Didi0dum/GPR/synth-vco/synth-vco.csv

Reference | Qty | Value | DNP | Exclude from BOM | Exclude from Board | Exclude from Simulation | Exclude from Position Files | Footprint | Datasheet
AR1 | 1 | ADL5611ARKZ-R7 |  |  |  |  | ${EXCLUDE_FROM_POS_FILES} | GPR_Radar_Footprints:AMP_ADL5611ARKZ-R7 | https://www.analog.com/media/en/technical-documentation/data-sheets/adl5611.pdf
AT1 | 1 | PAT1220-C-3DB |  |  |  |  | ${EXCLUDE_FROM_POS_FILES} | GPR_Radar_Footprints:ATTN_PAT1220-C-10DB-T5 | https://www.mouser.com/catalog/specsheets/Susumu_01192017_PAT.pdf
C1,C11 | 2 | 1n |  |  |  |  | ${EXCLUDE_FROM_POS_FILES} | Capacitor_SMD:C_0603_1608Metric_Pad1.08x0.95mm_HandSolder
C2 | 1 | 1000p |  |  |  |  | ${EXCLUDE_FROM_POS_FILES} | Capacitor_SMD:C_0603_1608Metric_Pad1.08x0.95mm_HandSolder
C3,C10,C56,C57,C59,C61,C63 | 7 | 100n |  |  |  |  | ${EXCLUDE_FROM_POS_FILES} | Capacitor_SMD:C_0603_1608Metric_Pad1.08x0.95mm_HandSolder
C4,C5,C12,C13,C14,C20,C22,C66,C68,C72 | 10 | 100pF |  |  |  |  | ${EXCLUDE_FROM_POS_FILES} | Capacitor_SMD:C_0603_1608Metric_Pad1.08x0.95mm_HandSolder
C6 | 1 | 160nF |  |  |  |  | ${EXCLUDE_FROM_POS_FILES} | Capacitor_SMD:C_1206_3216Metric_Pad1.33x1.80mm_HandSolder
C7 | 1 | 5.6uF |  |  |  |  | ${EXCLUDE_FROM_POS_FILES} | Capacitor_SMD:C_1206_3216Metric_Pad1.33x1.80mm_HandSolder
C8,C50,C52,C53,C54 | 5 | 10n |  |  |  |  | ${EXCLUDE_FROM_POS_FILES} | Capacitor_SMD:C_0603_1608Metric_Pad1.08x0.95mm_HandSolder
C9 | 1 | 33nF |  |  |  |  | ${EXCLUDE_FROM_POS_FILES} | Capacitor_SMD:C_1206_3216Metric_Pad1.33x1.80mm_HandSolder
C15 | 1 | 68pF |  |  |  |  | ${EXCLUDE_FROM_POS_FILES} | Capacitor_SMD:C_0603_1608Metric_Pad1.08x0.95mm_HandSolder
C16 | 1 | 1.2nF |  |  |  |  | ${EXCLUDE_FROM_POS_FILES} | Capacitor_SMD:C_0603_1608Metric_Pad1.08x0.95mm_HandSolder
C17,C69 | 2 | 1uF |  |  |  |  | ${EXCLUDE_FROM_POS_FILES} | Capacitor_SMD:C_0603_1608Metric_Pad1.08x0.95mm_HandSolder
C18 | 1 | 100nF |  |  |  |  | ${EXCLUDE_FROM_POS_FILES} | Capacitor_SMD:C_0603_1608Metric_Pad1.08x0.95mm_HandSolder
C23,C31,C34,C36,C39,C42 | 6 | 4.7u |  |  |  |  | ${EXCLUDE_FROM_POS_FILES} | Capacitor_SMD:C_0805_2012Metric_Pad1.18x1.45mm_HandSolder
C24,C29,C30,C32,C33,C35,C38,C41,C44,C70 | 10 | 10u |  |  |  |  | ${EXCLUDE_FROM_POS_FILES} | Capacitor_SMD:C_0805_2012Metric_Pad1.18x1.45mm_HandSolder
C25,C27,C51,C55,C65 | 5 | 10u |  |  |  |  | ${EXCLUDE_FROM_POS_FILES} | Capacitor_SMD:C_1206_3216Metric_Pad1.33x1.80mm_HandSolder
C26,C28 | 2 | 22u |  |  |  |  | ${EXCLUDE_FROM_POS_FILES} | Capacitor_SMD:C_1206_3216Metric_Pad1.33x1.80mm_HandSolder
C37,C40,C43 | 3 | 0.47u |  |  |  |  | ${EXCLUDE_FROM_POS_FILES} | Capacitor_SMD:C_0603_1608Metric_Pad1.08x0.95mm_HandSolder
C45 | 1 | 470n |  |  |  |  | ${EXCLUDE_FROM_POS_FILES} | Capacitor_SMD:C_0603_1608Metric_Pad1.08x0.95mm_HandSolder
C46 | 1 | 0.1u |  |  |  |  | ${EXCLUDE_FROM_POS_FILES} | Capacitor_SMD:C_0603_1608Metric_Pad1.08x0.95mm_HandSolder
C47 | 1 | 2.2n |  |  |  |  | ${EXCLUDE_FROM_POS_FILES} | Capacitor_SMD:C_0603_1608Metric_Pad1.08x0.95mm_HandSolder
C48 | 1 | 47p |  |  |  |  | ${EXCLUDE_FROM_POS_FILES} | Capacitor_SMD:C_0603_1608Metric_Pad1.08x0.95mm_HandSolder
C49 | 1 | 4.7u |  |  |  |  | ${EXCLUDE_FROM_POS_FILES} | Capacitor_SMD:C_1206_3216Metric_Pad1.33x1.80mm_HandSolder
C58,C60,C62,C64 | 4 | 10p |  |  |  |  | ${EXCLUDE_FROM_POS_FILES} | Capacitor_SMD:C_0603_1608Metric_Pad1.08x0.95mm_HandSolder
C67 | 1 | 9pF |  |  |  |  | ${EXCLUDE_FROM_POS_FILES} | Capacitor_SMD:C_0603_1608Metric_Pad1.08x0.95mm_HandSolder
C71 | 1 | 1.8pF |  |  |  |  | ${EXCLUDE_FROM_POS_FILES} | Capacitor_SMD:C_0603_1608Metric_Pad1.08x0.95mm_HandSolder
C73,C74 | 2 | 2.2u |  |  |  |  | ${EXCLUDE_FROM_POS_FILES} | Capacitor_SMD:C_0805_2012Metric_Pad1.18x1.45mm_HandSolder
D1 | 1 | MSS1P4-M3_89A |  |  |  |  | ${EXCLUDE_FROM_POS_FILES} | GPR_Radar_Footprints:DIODE_MSS1P4-M3_89A
D3 | 1 | WE-TVSP_DO |  |  |  |  | ${EXCLUDE_FROM_POS_FILES} | GPR_Radar_Footprints:WE-TVSP_DO-214AC_UNIDIRECTIONAL | https://www.we-online.com/components/products/datasheet/824500141.pdf
F1 | 1 | MF-MSMF200/16X |  |  |  |  | ${EXCLUDE_FROM_POS_FILES} | GPR_Radar_Footprints:FUSER_MF-MSMF200 | https://www.mouser.bg/datasheet/3/40/1/mf_msmf.pdf
FL1,FL2 | 2 | BLM18EG331TZ1D |  |  |  |  | ${EXCLUDE_FROM_POS_FILES} | GPR_Radar_Footprints:BEADC1608X65N
FL3,FL4 | 2 | LFCN-900+ |  |  |  |  | ${EXCLUDE_FROM_POS_FILES} | Filter:Filter_Mini-Circuits_FV1206 | https://eu.mouser.com/datasheet/3/3705/1/LFCN_900.pdf
J1,J4 | 2 | Conn_Coaxial |  |  |  |  | ${EXCLUDE_FROM_POS_FILES} | Connector_Coaxial:SMA_Samtec_SMA-J-P-H-ST-EM1_EdgeMount
J2 | 1 | Screw_Terminal_01x02 |  |  |  |  | ${EXCLUDE_FROM_POS_FILES} | TerminalBlock_CUI:TerminalBlock_CUI_TB007-508-02_1x02_P5.08mm_Horizontal
J3 | 1 | 61202021621 |  |  |  |  | ${EXCLUDE_FROM_POS_FILES} | GPR_Radar_Footprints:J_Wurth_WR-BHD_61202021621 | https://www.we-online.com/en/components/products/datasheet/61202021621?ki
L1 | 1 | 43nH |  |  |  |  | ${EXCLUDE_FROM_POS_FILES} | Inductor_SMD:L_0603_1608Metric_Pad1.05x0.95mm_HandSolder
L2 | 1 | 47.0 uH |  |  |  |  | ${EXCLUDE_FROM_POS_FILES} | GPR_Radar_Footprints:L_Wurth_WE-LQS-4018 | https://www.we-online.com/catalog/datasheet/74404042470.pdf?ki
L3 | 1 | 82uH |  |  |  |  | ${EXCLUDE_FROM_POS_FILES} | Inductor_SMD:L_0805_2012Metric_Pad1.05x1.20mm_HandSolder
L5 | 1 | 82nH |  |  |  |  | ${EXCLUDE_FROM_POS_FILES} | Inductor_SMD:L_0603_1608Metric_Pad1.05x0.95mm_HandSolder
L6 | 1 | 3.9nH |  |  |  |  | ${EXCLUDE_FROM_POS_FILES} | Inductor_SMD:L_0603_1608Metric_Pad1.05x0.95mm_HandSolder
R1 | 1 | 5.1K |  |  |  |  | ${EXCLUDE_FROM_POS_FILES} | Resistor_SMD:R_0603_1608Metric_Pad0.98x0.95mm_HandSolder
R2,R23 | 2 | 2K |  |  |  |  | ${EXCLUDE_FROM_POS_FILES} | Resistor_SMD:R_0603_1608Metric_Pad0.98x0.95mm_HandSolder
R3 | 1 | 5.62 |  |  |  |  | ${EXCLUDE_FROM_POS_FILES} | Resistor_SMD:R_0603_1608Metric_Pad0.98x0.95mm_HandSolder
R4,R14,R15,R16,R17,R18,R19,R20,R21,R22,R30 | 11 | 10K |  |  |  |  | ${EXCLUDE_FROM_POS_FILES} | Resistor_SMD:R_0603_1608Metric_Pad0.98x0.95mm_HandSolder
R5 | 1 | 1K |  |  |  |  | ${EXCLUDE_FROM_POS_FILES} | Resistor_SMD:R_0603_1608Metric_Pad0.98x0.95mm_HandSolder
R6 | 1 | 1.8K |  |  |  |  | ${EXCLUDE_FROM_POS_FILES} | Resistor_SMD:R_0603_1608Metric_Pad0.98x0.95mm_HandSolder
R7 | 1 | 33 |  |  |  |  | ${EXCLUDE_FROM_POS_FILES} | Resistor_SMD:R_0603_1608Metric_Pad0.98x0.95mm_HandSolder
R8,R38 | 2 | 10 |  |  |  |  | ${EXCLUDE_FROM_POS_FILES} | Resistor_SMD:R_0603_1608Metric_Pad0.98x0.95mm_HandSolder
R9 | 1 | 150 |  |  |  |  | ${EXCLUDE_FROM_POS_FILES} | Resistor_SMD:R_0603_1608Metric_Pad0.98x0.95mm_HandSolder
R10 | 1 | 51 |  |  |  |  | ${EXCLUDE_FROM_POS_FILES} | Resistor_SMD:R_0603_1608Metric_Pad0.98x0.95mm_HandSolder
R11 | 1 | 120 |  |  |  |  | ${EXCLUDE_FROM_POS_FILES} | Resistor_SMD:R_0603_1608Metric_Pad0.98x0.95mm_HandSolder
R12,R13 | 2 | 75 |  |  |  |  | ${EXCLUDE_FROM_POS_FILES} | Resistor_SMD:R_0603_1608Metric_Pad0.98x0.95mm_HandSolder
R24,R25,R26 | 3 | 49.9K |  |  |  |  | ${EXCLUDE_FROM_POS_FILES} | Resistor_SMD:R_0603_1608Metric_Pad0.98x0.95mm_HandSolder
R27,R28,R29 | 3 | 32.4K |  |  |  |  | ${EXCLUDE_FROM_POS_FILES} | Resistor_SMD:R_0603_1608Metric_Pad0.98x0.95mm_HandSolder
R31 | 1 | 56k |  |  |  |  | ${EXCLUDE_FROM_POS_FILES} | Resistor_SMD:R_0603_1608Metric_Pad0.98x0.95mm_HandSolder
R32 | 1 | 226K |  |  |  |  | ${EXCLUDE_FROM_POS_FILES} | Resistor_SMD:R_0603_1608Metric_Pad0.98x0.95mm_HandSolder
R33 | 1 | 6.19K |  |  |  |  | ${EXCLUDE_FROM_POS_FILES} | Resistor_SMD:R_0603_1608Metric_Pad0.98x0.95mm_HandSolder
R34 | 1 | 1.15M |  |  |  |  | ${EXCLUDE_FROM_POS_FILES} | Resistor_SMD:R_0603_1608Metric_Pad0.98x0.95mm_HandSolder
R35,R37 | 2 | 60.4K |  |  |  |  | ${EXCLUDE_FROM_POS_FILES} | Resistor_SMD:R_0603_1608Metric_Pad0.98x0.95mm_HandSolder
R36 | 1 | 1.74M |  |  |  |  | ${EXCLUDE_FROM_POS_FILES} | Resistor_SMD:R_0603_1608Metric_Pad0.98x0.95mm_HandSolder
R45,R46 | 2 | 500K |  |  |  |  | ${EXCLUDE_FROM_POS_FILES} | Resistor_SMD:R_0603_1608Metric_Pad0.98x0.95mm_HandSolder
U1 | 1 | ADF4158 |  |  |  |  | ${EXCLUDE_FROM_POS_FILES} | Package_CSP:LFCSP-24-1EP_4x4mm_P0.5mm_EP2.5x2.5mm | https://www.analog.com/media/en/technical-documentation/data-sheets/ADF4158.pdf
U3 | 1 | ADP-2-10+ |  |  |  |  | ${EXCLUDE_FROM_POS_FILES} | GPR_Radar_Footprints:CD636 | https://www.minicircuits.com/pdfs/ADP-2-10+.pdf
U4 | 1 | DAT-15R5A-SP+ |  |  |  |  | ${EXCLUDE_FROM_POS_FILES} | GPR_Radar_Footprints:MiniCircuits_DG983-2 | https://www.minicircuits.com/pdfs/DAT-15R5A-SP+.pdf
U5 | 1 | OPA192IDGKT |  |  |  |  | ${EXCLUDE_FROM_POS_FILES} | GPR_Radar_Footprints:SOP65P490X110-8N
U6 | 1 | TPSM53602RDAR |  |  |  |  | ${EXCLUDE_FROM_POS_FILES} | GPR_Radar_Footprints:IC_TPSM53603RDAR
U7,U8,U9,U10,U11,U12 | 6 | LT3045IMSE_TRPBF |  |  |  |  | ${EXCLUDE_FROM_POS_FILES} | GPR_Radar_Footprints:SOP65P490X110-13N
U13 | 1 | LT8570EMS8E_TRPBF |  |  |  |  | ${EXCLUDE_FROM_POS_FILES} | GPR_Radar_Footprints:SOP65P490X110-9N
U14,U15 | 2 | LT3065EDDPBF |  |  |  |  | ${EXCLUDE_FROM_POS_FILES} | GPR_Radar_Footprints:DFN-10_DD
U16 | 1 | BT09E |  |  |  |  | ${EXCLUDE_FROM_POS_FILES} | Package_TO_SOT_SMD:SOT-89-3 | https://d2lxe0fofddnat.cloudfront.net/BT09E-V8.3.pdf
Y1 | 1 | FT3MN 26 MHz |  |  |  |  | ${EXCLUDE_FROM_POS_FILES} | GPR_Radar_Footprints:TCXO_FT3MN_3.2x2.5mm
Y3 | 1 | CVCO55CW-0500-1000 |  |  |  |  | ${EXCLUDE_FROM_POS_FILES} | GPR_Radar_Footprints:XTAL_CVCO55CW-0500-1000 | https://www.crystek.com/Specification/CVCO55CW-0500-1000
