Didi0dum/GPR/synth-vco/synth-vco.kicad_pcb

## KiCad design synth-vco/synth-vco.kicad_pcb (2026-11-07)

Schematic: synth-vco.kicad_sch

Parts:
AR1: ADL5611ARKZ-R7; AMP_ADL5611ARKZ-R7; PARTREV B
AT1: PAT1220-C-3DB; ATTN_PAT1220-C-10DB-T5
C1, C11: 1n; C_0603_1608Metric_Pad1.08x0.95mm_HandSolder
C2: 1000p; C_0603_1608Metric_Pad1.08x0.95mm_HandSolder
C3, C10, C56, C57, C59, C61, C63: 100n; C_0603_1608Metric_Pad1.08x0.95mm_HandSolder
C4, C5, C12, C13, C14, C20, C22, C66, C68, C72: 100pF; C_0603_1608Metric_Pad1.08x0.95mm_HandSolder
C6: 160nF; C_1206_3216Metric_Pad1.33x1.80mm_HandSolder
C7: 5.6uF; C_1206_3216Metric_Pad1.33x1.80mm_HandSolder
C8, C50, C52, C53, C54: 10n; C_0603_1608Metric_Pad1.08x0.95mm_HandSolder
C9: 33nF; C_1206_3216Metric_Pad1.33x1.80mm_HandSolder
C15: 68pF; C_0603_1608Metric_Pad1.08x0.95mm_HandSolder
C16: 1.2nF; C_0603_1608Metric_Pad1.08x0.95mm_HandSolder
C17, C69: 1uF; C_0603_1608Metric_Pad1.08x0.95mm_HandSolder
C18: 100nF; C_0603_1608Metric_Pad1.08x0.95mm_HandSolder
C23, C31, C34, C36, C39, C42: 4.7u; C_0805_2012Metric_Pad1.18x1.45mm_HandSolder
C24, C29, C30, C32, C33, C35, C38, C41, C44, C70: 10u; C_0805_2012Metric_Pad1.18x1.45mm_HandSolder
C25, C27, C51, C55, C65: 10u; C_1206_3216Metric_Pad1.33x1.80mm_HandSolder
C26, C28: 22u; C_1206_3216Metric_Pad1.33x1.80mm_HandSolder
C37, C40, C43: 0.47u; C_0603_1608Metric_Pad1.08x0.95mm_HandSolder
C45: 470n; C_0603_1608Metric_Pad1.08x0.95mm_HandSolder
C46: 0.1u; C_0603_1608Metric_Pad1.08x0.95mm_HandSolder
C47: 2.2n; C_0603_1608Metric_Pad1.08x0.95mm_HandSolder
C48: 47p; C_0603_1608Metric_Pad1.08x0.95mm_HandSolder
C49: 4.7u; C_1206_3216Metric_Pad1.33x1.80mm_HandSolder
C58, C60, C62, C64: 10p; C_0603_1608Metric_Pad1.08x0.95mm_HandSolder
C67: 9pF; C_0603_1608Metric_Pad1.08x0.95mm_HandSolder
C71: 1.8pF; C_0603_1608Metric_Pad1.08x0.95mm_HandSolder
C73, C74: 2.2u; C_0805_2012Metric_Pad1.18x1.45mm_HandSolder
D1: MSS1P4-M3_89A; DIODE_MSS1P4-M3_89A
D3: WE-TVSP_DO; WE-TVSP_DO-214AC_UNIDIRECTIONAL
F1: MF-MSMF200/16X; FUSER_MF-MSMF200
FL1, FL2: BLM18EG331TZ1D; BEADC1608X65N; DigiKey_Part_Number 490-BLM18EG331TZ1DTR-ND
FL3, FL4: LFCN-900+; Filter_Mini-Circuits_FV1206
J1, J4: Conn_Coaxial; SMA_Samtec_SMA-J-P-H-ST-EM1_EdgeMount
J2: Screw_Terminal_01x02; TerminalBlock_CUI_TB007-508-02_1x02_P5.08mm_Horizontal
J3: 61202021621; J_Wurth_WR-BHD_61202021621; Working Voltage (V (AC)) 250
L1: 43nH; L_0603_1608Metric_Pad1.05x0.95mm_HandSolder
L2: 47.0 uH; L_Wurth_WE-LQS-4018; Part Number 74404042470
L3: 82uH; L_0805_2012Metric_Pad1.05x1.20mm_HandSolder
L5: 82nH; L_0603_1608Metric_Pad1.05x0.95mm_HandSolder
L6: 3.9nH; L_0603_1608Metric_Pad1.05x0.95mm_HandSolder
NT1: NetTie_2; NetTie-2_SMD_Pad0.5mm
R1: 5.1K; R_0603_1608Metric_Pad0.98x0.95mm_HandSolder
R2, R23: 2K; R_0603_1608Metric_Pad0.98x0.95mm_HandSolder
R3: 5.62; R_0603_1608Metric_Pad0.98x0.95mm_HandSolder
R4, R14, R15, R16, R17, R18, R19, R20, R21, R22, R30: 10K; R_0603_1608Metric_Pad0.98x0.95mm_HandSolder
R5: 1K; R_0603_1608Metric_Pad0.98x0.95mm_HandSolder
R6: 1.8K; R_0603_1608Metric_Pad0.98x0.95mm_HandSolder
R7: 33; R_0603_1608Metric_Pad0.98x0.95mm_HandSolder
R8, R38: 10; R_0603_1608Metric_Pad0.98x0.95mm_HandSolder
R9: 150; R_0603_1608Metric_Pad0.98x0.95mm_HandSolder
R10: 51; R_0603_1608Metric_Pad0.98x0.95mm_HandSolder
R11: 120; R_0603_1608Metric_Pad0.98x0.95mm_HandSolder
R12, R13: 75; R_0603_1608Metric_Pad0.98x0.95mm_HandSolder
R24, R25, R26: 49.9K; R_0603_1608Metric_Pad0.98x0.95mm_HandSolder
R27, R28: 32.4K; R_0603_1608Metric_Pad0.98x0.95mm_HandSolder; Tolerance 0.1%
R29: 32.4K; R_0603_1608Metric_Pad0.98x0.95mm_HandSolder
R31: 56k; R_0603_1608Metric_Pad0.98x0.95mm_HandSolder
R32: 226K; R_0603_1608Metric_Pad0.98x0.95mm_HandSolder
R33: 6.19K; R_0603_1608Metric_Pad0.98x0.95mm_HandSolder
R34: 1.15M; R_0603_1608Metric_Pad0.98x0.95mm_HandSolder
R35, R37: 60.4K; R_0603_1608Metric_Pad0.98x0.95mm_HandSolder
R36: 1.74M; R_0603_1608Metric_Pad0.98x0.95mm_HandSolder
R45, R46: 500K; R_0603_1608Metric_Pad0.98x0.95mm_HandSolder
U1: ADF4158; LFCSP-24-1EP_4x4mm_P0.5mm_EP2.5x2.5mm
U3: ADP-2-10+; CD636
U4: DAT-15R5A-SP+; MiniCircuits_DG983-2
U5: OPA192IDGKT; SOP65P490X110-8N
U6: TPSM53602RDAR; IC_TPSM53603RDAR; PARTREV A
U7, U8, U9, U10, U11, U12: LT3045IMSE_TRPBF; SOP65P490X110-13N; PARTREV D
U13: LT8570EMS8E_TRPBF; SOP65P490X110-9N; PARTREV A
U14, U15: LT3065EDDPBF; DFN-10_DD; MANUFACTURER_PART_NUMBER lt3065edd#pbf
U16: BT09E; SOT-89-3
Y1: FT3MN 26 MHz; TCXO_FT3MN_3.2x2.5mm
Y3: CVCO55CW-0500-1000; XTAL_CVCO55CW-0500-1000; DigiKey_Part_Number 744-1208-ND

Connections:
+3V3_PLL_A: C38.2, C59.1, C60.1, U1.6 (AVDD), U1.7 (AVDD), U1.8 (AVDD), U10.10 (OUTS), U10.11 (OUT), U10.12 (OUT)
+3V3_PLL_D: C41.2, C56.1, C57.1, C58.1, C61.1, C62.1, R4.2, R15.2, R16.2, R17.2, R18.2, R19.2, U1.18 (SDVDD), U1.19 (DVDD), U4.6 (VDD), U4.9 (VDD), U4.13 (VDD), U11.10 (OUTS), U11.11 (OUT), U11.12 (OUT)
+3V3_TCXO: C44.2, FL1.2, U12.10 (OUTS), U12.11 (OUT), U12.12 (OUT)
+5V_ADL5611: C15.1, C16.2, C17.2, C35.2, L1.2, U9.10 (OUTS), U9.11 (OUT), U9.12 (OUT)
+5V_BT09E: C32.2, C68.2, C69.2, C70.2, L5.2, U8.10 (OUTS), U8.11 (OUT), U8.12 (OUT)
+5V_VP: C24.2, C63.1, C64.1, U1.22 (VP), U7.10 (OUTS), U7.11 (OUT), U7.12 (OUT)
+6V_PRE: C26.2, C28.2, C29.2, C30.2, C33.2, C36.2, C39.2, C42.2, R22.2, U6.7 (VOUT), U6.8 (VOUT), U7.1 (IN), U7.2 (IN), U7.3 (IN), U7.4 (EN/UV), U7.7 (PGFB), U8.1 (IN), U8.2 (IN), U8.3 (IN), U8.4 (EN/UV), U8.7 (PGFB), U9.1 (IN), U9.2 (IN), U9.3 (IN), U9.4 (EN/UV), U9.7 (PGFB), U10.1 (IN), U10.2 (IN), U10.3 (IN), U10.4 (EN/UV), U10.7 (PGFB), U11.1 (IN), U11.2 (IN), U11.3 (IN), U11.4 (EN/UV), U11.7 (PGFB), U12.1 (IN), U12.2 (IN), U12.3 (IN), U12.4 (EN/UV), U12.7 (PGFB)
+12V_IN: C25.2, C27.2, C45.2, D3.1, F1.2, L2.1, R30.2, U6.1 (VIN), U6.2 (EN), U6.14 (VIN), U13.3 (VIN)
+12V_VCO: C50.2, C51.2, FL2.2, R34.1, U14.9 (OUT), U14.10 (OUT)
+18V_OPA: C18.1, C54.2, C55.2, R36.1, U5.7 (V+), U15.9 (OUT), U15.10 (OUT)
+20V_PRE: C65.2, C73.2, C74.2, R38.1, R45.1, R46.1, U14.1 (IN), U14.2 (IN), U14.3 (~SHDN), U15.1 (IN), U15.2 (IN), U15.3 (~SHDN)
/ATT_CLK: J3.15, U4.4 (CLK)
/ATT_DATA: J3.17, R20.1
/ATT_LE: J3.13, R21.2, U4.5 (LE)
/PLL_CE: J3.3, U1.13 (CE)
/PLL_LE: J3.9, U1.16 (LE)
/PLL_MUXOUT: C8.2, J3.11, R2.2, R4.1
/PLL_TXDATA: J3.1, U1.12 (TXDATA)
/SPI_CLK: J3.5, U1.14 (CLK)
/SPI_DATA: J3.7, U1.15 (DATA)
GND: AR1.2_4 (GND), AT1.3 (GND), C1.1, C3.1, C4.2, C6.2, C7.2, C8.1, C9.2, C10.1, C11.2, C15.2, C16.1, C17.1, C18.2, C23.1, C24.1, C25.1, C26.1, C27.1, C28.1, C29.1, C30.1, C31.1, C32.1, C33.1, C34.1, C35.1, C36.1, C37.1, C38.1, C39.1, C40.1, C41.1, C42.1, C43.1, C44.1, C45.1, C46.1, C47.1, C48.1, C49.1, C51.1, C52.1, C53.1, C55.1, C56.2, C57.2, C58.2, C59.2, C60.2, C61.2, C62.2, C63.2, C64.2, C65.1, C67.1, C68.1, C69.1, C70.1, C71.1, C73.1, C74.1, D3.2, FL3.2 (GND), FL3.4 (GND), FL4.2 (GND), FL4.4 (GND), J1.2 (Ext), J2.1, J3.2, J3.4, J3.6, J3.8, J3.10, J3.12, J3.14, J3.16, J3.18, J3.19, J3.20, J4.2 (Ext), NT1.2, R1.1, R5.2, R10.2, R12.1, R13.1, R14.1, R21.1, R24.2, R25.2, R26.2, R27.2, R28.2, R29.2, R31.1, R35.2, R37.2, U1.1 (CPGND), U1.2 (AGND), U1.3 (AGND), U1.10 (DGND), U1.11 (SDGND), U1.25 (AGND), U3.6 (GND), U4.10 (GND), U4.11 (GND), U4.12 (GND), U4.18 (GND), U4.21 (GND), U5.4 (V-), U6.3 (NC), U6.10 (NC), U6.11 (NC), U6.15 (PGND), U6.15_1 (PGND), U6.15_2 (PGND), U6.15_3 (PGND), U6.15_4 (PGND), U6.15_5 (PGND), U6.15_6 (PGND), U6.15_7 (PGND), U6.15_8 (PGND), U6.15_9 (PGND), U6.15_10 (PGND), U6.15_11 (PGND), U7.6 (ILIM), U7.9 (GND), U7.13 (EXP), U8.6 (ILIM), U8.9 (GND), U8.13 (EXP), U9.6 (ILIM), U9.9 (GND), U9.13 (EXP), U10.6 (ILIM), U10.9 (GND), U10.13 (EXP), U11.6 (ILIM), U11.9 (GND), U11.13 (EXP), U12.6 (ILIM), U12.9 (GND), U12.13 (EXP), U13.8 (SYNC), U13.9 (GND), U14.5 (IMAX), U14.7 (GND), U14.11 (GND), U15.5 (IMAX), U15.7 (GND), U15.11 (GND), U16.2 (GND), Y1.1 (GND), Y1.2 (GND), Y3.1 (GND), Y3.3 (GND), Y3.4 (GND), Y3.5 (GND), Y3.6 (GND), Y3.7 (GND), Y3.8 (GND), Y3.9 (GND), Y3.11 (GND), Y3.12 (GND), Y3.13 (GND), Y3.15 (GND), Y3.16 (GND)
unnamed: AR1.1 (RFIN), C13.2
unnamed: AR1.3 (RFOUT), C14.1, L1.1
unnamed: AT1.1 (IN), U3.4 (P2)
unnamed: AT1.2 (OUT), C20.1
unnamed: C5.2, R9.2, R10.1
unnamed: C7.1, R3.2
unnamed: C12.2, R8.1
unnamed: C13.1, R11.2, R13.2
unnamed: C47.2, R33.2
unnamed: C49.2, D1.1, R32.1, R38.2
unnamed: C71.2, C72.1, L6.2
unnamed: C14.2, FL3.1 (IN)
unnamed: FL3.3 (OUT), U3.1 (SUM)
unnamed: C72.2, FL4.1 (IN)
unnamed: FL4.3 (OUT), J4.1 (In)
unnamed: C20.2, J1.1 (In)
unnamed: F1.1, J2.2
unnamed: L3.2, R7.2
unnamed: R8.2, R9.1, R11.1, R12.2
unnamed: C6.1, R3.1, U1.24 (CP), U5.3 (+IN)
unnamed: R2.1, U1.17 (MUXOUT)
unnamed: C2.2, U1.9 (REFIN)
unnamed: C5.1, U1.5 (RFINA)
unnamed: C4.1, U1.4 (RFINB)
unnamed: R1.2, U1.23 (RSET)
unnamed: C22.2, U3.3 (P1)
unnamed: R18.1, U4.20 (C0.5)
unnamed: R17.1, U4.19 (C1)
unnamed: R16.1, U4.17 (C2)
unnamed: R15.1, U4.16 (C4)
unnamed: R19.1, U4.15 (C8)
unnamed: R20.2, U4.3 (DATA)
unnamed: R14.2, U4.1 (N/C)
unnamed: C22.1, U4.2 (RF_in)
unnamed: C66.1, U4.14 (RFout)
unnamed: R5.1, R6.1, U5.2 (-IN)
unnamed: R6.2, R7.1, U5.6 (OUT)
unnamed: NT1.1, R23.1, U6.12 (AGND)
unnamed: R22.1, R23.2, U6.9 (FB)
unnamed: C23.2, R24.1, U7.8 (SET)
unnamed: C31.2, R25.1, U8.8 (SET)
unnamed: C34.2, R26.1, U9.8 (SET)
unnamed: C37.2, R27.1, U10.8 (SET)
unnamed: C40.2, R28.1, U11.8 (SET)
unnamed: C43.2, R29.1, U12.8 (SET)
unnamed: R32.2, U13.1 (FBX)
unnamed: R31.2, U13.6 (RT)
unnamed: C46.2, U13.7 (SS)
unnamed: D1.2, L2.2, U13.4 (SW)
unnamed: C48.2, R33.1, U13.2 (VC)
unnamed: R30.1, U13.5 (~SHDN)
unnamed: C50.1, R34.2, R35.1, U14.8 (ADJ)
unnamed: R45.2, U14.4 (PWRGD)
unnamed: C52.2, U14.6 (REF/BYP)
unnamed: C54.1, R36.2, R37.1, U15.8 (ADJ)
unnamed: R46.2, U15.4 (PWRGD)
unnamed: C53.2, U15.6 (REF/BYP)
unnamed: C66.2, C67.2, U16.1 (RF_in)
unnamed: L5.1, L6.1, U16.3 (RF_out)
unnamed: C2.1, Y1.3 (OUT)
unnamed: C1.2, C3.2, FL1.1, Y1.4 (VDD)
unnamed: C12.1, Y3.10 (RF-OUT)
unnamed: C10.2, C11.1, FL2.1, Y3.14 (VCC)
unnamed: C9.1, L3.1, Y3.2 (VT)

Notes on the sheet:
5V Lines
3V3 Lines
12V Line
Boost to 20V
18V Line

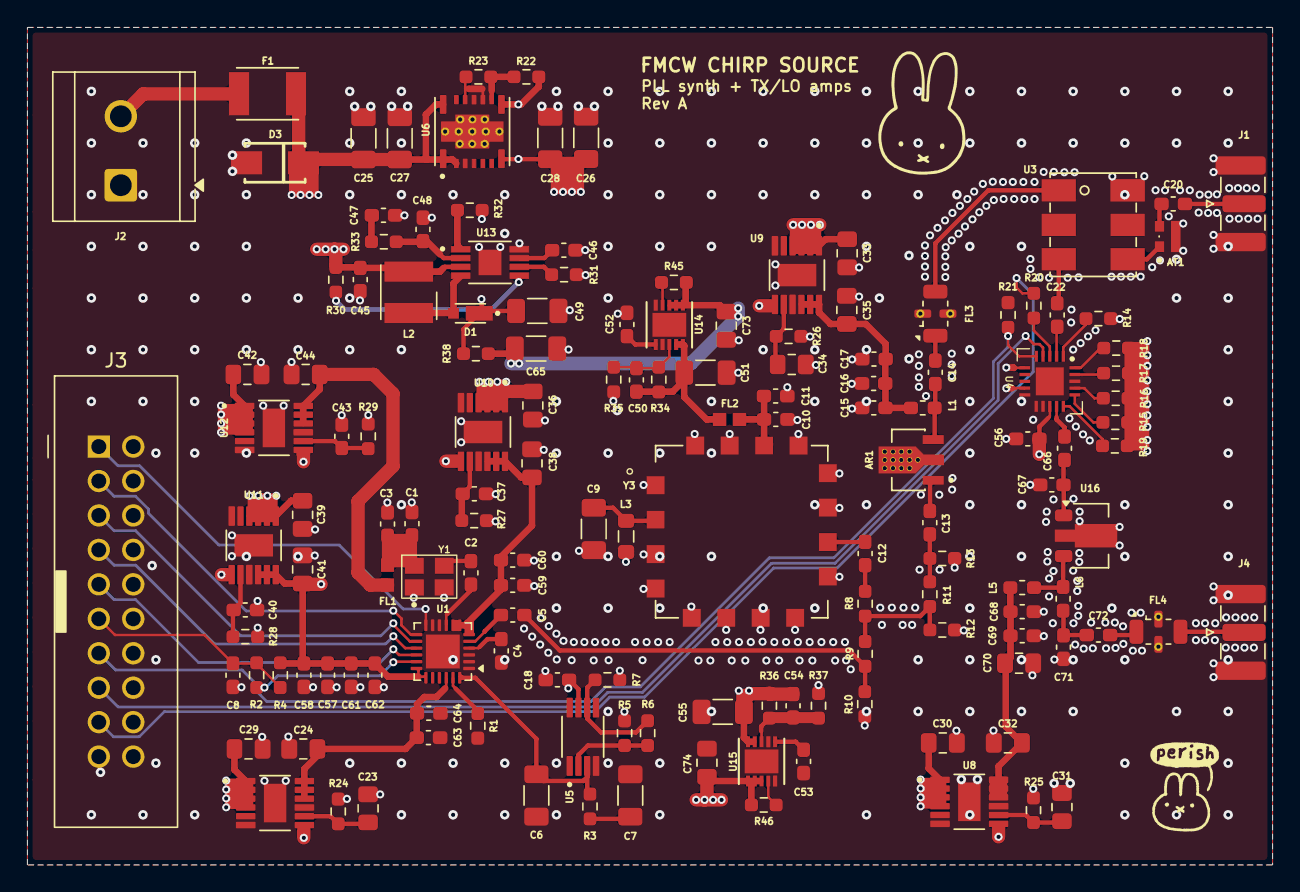
[picture p1: board synth-vco.kicad_pcb from above]

Board: 4 copper layers, 91.8 x 61.8 mm, 148 parts (0 on the bottom side), 85 nets.
