Didi0dum/GPR/(commit log)

2026-10-02 Initial commit: existing tx rf path
    I did not know I could start a github repo in my kicad project (which is kind of my bad I didn't check for this earlier) so I have most of the tx rf path schematic ready.
    [synth-vco.kicad_pcb, synth-vco.kicad_sch]
2026-10-04 reorder: added components' footprints and symbols files to the repo directory instead of them being unorganized in my downloads folder
    [synth-vco.kicad_sch]
2026-10-05 components: added symbols and footprints for LT3045IMSE_TRPBF and TPSM5360RDAR
2026-10-05 schematic-feat: made the schematic for external 12V buck to 6V + LDOs to 5V and 3V3 lines
    [synth-vco.kicad_sch]
2026-10-11 add: symbol, footprint and step for LT8570
2026-10-11 add: schottky diode footprint + lt8570 footprint
2026-10-11 add: boost 6V to 20V LT8570 schematic
2026-10-11 add: LT3065 and ADL5611 symbols, footprints and steps
2026-10-11 add: 12V and 18V lines from 20V, BT09E changed to power amp, ADL5611 before power splitter
2026-10-12 chore: switched default schottky diode to MSS1P4
2026-10-12 fix: resistors, capacitors and inductors footprints
2026-10-12 fix: switched the regular boost inductor for wurth's LQS-4018
2026-10-12 refactor: switched from screw terminals to pin header
2026-10-14 fix: adl5611 footprint
2026-10-15 refactor: changed barrel jack power input to screw terminal
2026-10-15 feat(power input): overvoltage and reverse polarity protection
2026-10-17 feat: initial pcb layout
2026-10-23 feat(power blocks): pcb layout of power blocks
2026-10-27 feat(rf layout): rf track pcb layout kind of completed
2026-10-27 feat: positioned power blocks
2026-10-27 refactor: switched to wurth box header
2026-10-28 fix: added power good pins' pull-up resistors
2026-10-31 fix: added 10K resistor at DATA line for DAT-15R5A-SP+ in accordance with the datasheet
2026-10-31 feat: silkscreen edits + art
2026-10-31 feat: silkscreen
2026-11-02 fix: reducing front paste and solder mask on some components
2026-11-02 fix: moved silkscreen references of some components
2026-11-02 feat: moved footprint library to lib/
2026-11-02 set-up: initial settings for second pcb
2026-11-02 add: LTC5584 symbol and footprint
2026-11-03 feat: Chebishev band pass filter of the 6th order
2026-11-04 feat: QPL9058TR7 LNA symbol and footprint
2026-11-04 feat: QPL9058TR7 LNA stage schematic
2026-11-04 feat: importing lfcn schematic symbol + added f.fab and courtyard to balun footprint
2026-11-04 feat: low-pass LFCN filter after LNA + ltc5584 rf matching
2026-11-07 feat: low-pass filters at I+ and I-
2026-11-07 add: THS4551 symbol and footprint
2026-11-09 feat: 12V to 6V buck, 5V Lines, 3V3 line
2026-11-09 fix: ltc5584 and ths4551 pin type changes to appease the erc
2026-11-12 feat: DC offset control schematic
